OwOday/glasgow_onesided/docs/manual/src/applets/memory/index.rst

.. _applet.memory:

Memory manipulation
===================

.. automodule:: glasgow.applet.memory

.. toctree::
    :maxdepth: 3

    24x
    25x
