OwOday/glasgow_onesided/docs/manual/src/applets/interface/spi_controller.rst

``spi-controller``
==================

CLI reference
-------------

.. _applet.interface.spi_controller:

.. autoprogram:: glasgow.applet.interface.spi_controller:SPIControllerApplet._get_argparser_for_sphinx("spi-controller")
    :prog: glasgow run spi-controller

API reference
-------------

.. module:: glasgow.applet.interface.spi_controller

.. autoclass:: SPIControllerInterface
