OwOday/glasgow_onesided/hardware/boards/glasgow/glasgow.kicad_pcb

## KiCad design hardware/boards/glasgow/glasgow.kicad_pcb (2026-03-15)

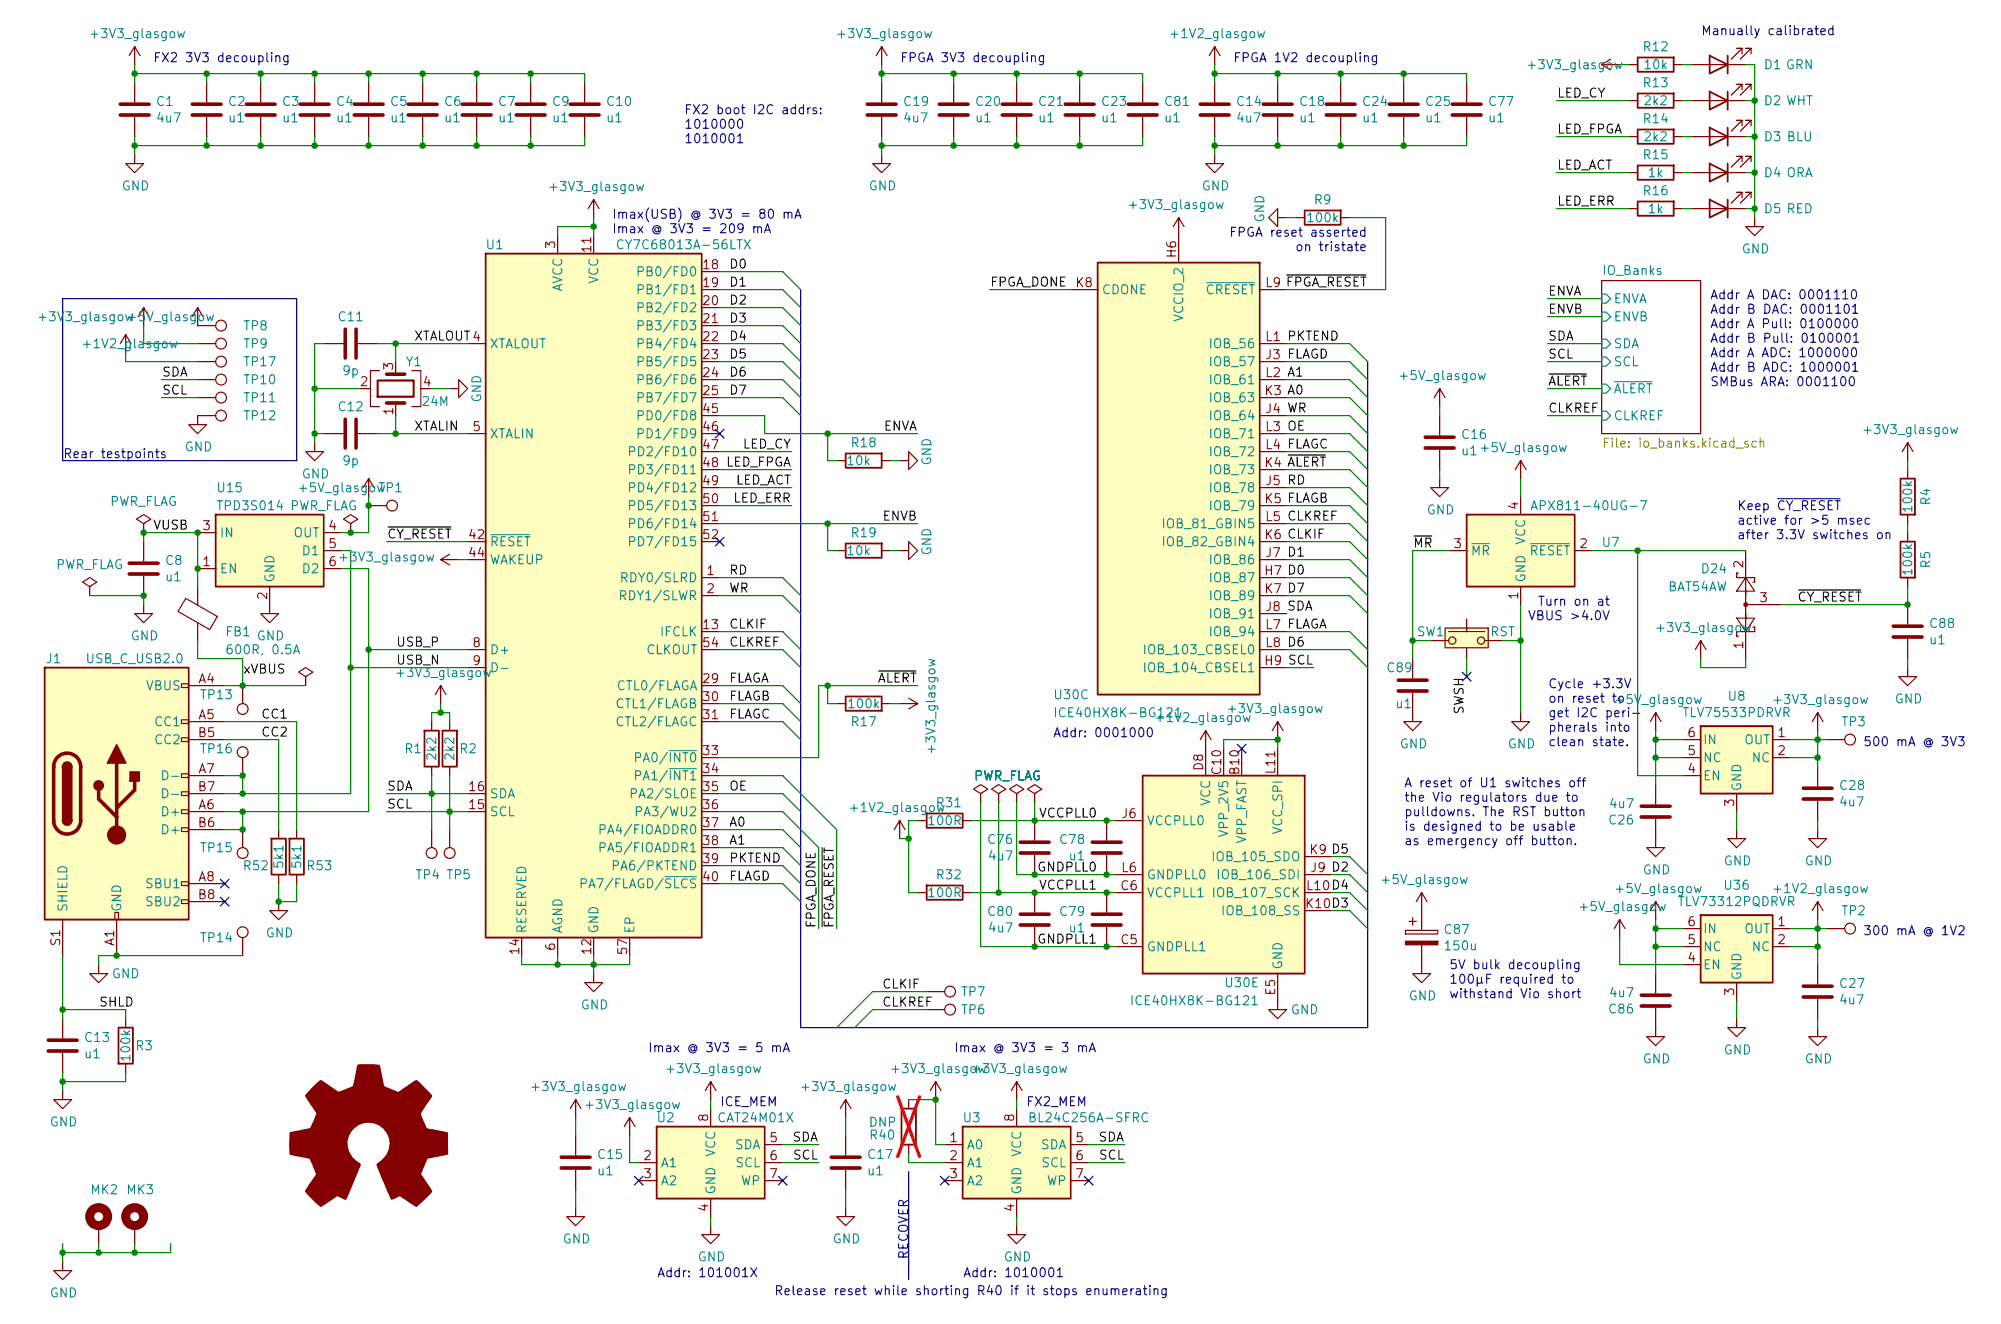
[picture p1: schematic glasgow.kicad_sch, Base Board]

Parts:
C1, C14, C19, C26, C27, C28, C76, C80, C86: 4u7; C_0603_1608Metric; MPN LMK107BJ475KAHT
C2, C3, C4, C5, C6, C7, C8, C9, C10, C13, C15, C16, C17, C18, C20, C21, C23, C24, C25, C77, C78, C79, C81, C88, C89: u1; C_0402_1005Metric; MPN TMK105BJ104KV-F
C11, C12: 9p; C_0402_1005Metric; MPN AC0402CRNPO9BN9R0
C87: 150u; CP_Elec_6.3x5.9; MPN A765EB157M1ALAE022
D1: GRN; LED_0603_1608Metric; MPN NCD0603G1
D2: WHT; LED_0603_1608Metric; MPN NCD0603W1
D3: BLU; LED_0603_1608Metric; MPN ORH-B36G
D4: ORA; LED_0603_1608Metric; MPN NCD0603O1
D5: RED; LED_0603_1608Metric; MPN NCD0603R1
D24: BAT54AW; SOT-323_SC-70; MPN BAT54AW-7-F
FB1: 600R, 0.5A; L_0402_1005Metric; MPN BLM15PX601SZ1D
J1: USB_C_USB2.0; USB_C_Receptacle_HRO_TYPE-C-31-M-12; MPN TYPE-C-31-M-12
MK2, MK3: Mounting_Hole_PAD; MountingHole_3.5mm_Pad_Via_CrtYd
R1, R2, R13, R14: 2k2; R_0402_1005Metric; MPN RC0402FR-132K2L
R3, R4, R5, R9, R17: 100k; R_0402_1005Metric; MPN RC0402FR-13100KL
R12, R18, R19: 10k; R_0402_1005Metric; MPN RC0402FR-1310KL
R15, R16: 1k; R_0402_1005Metric
R31, R32: 100R; R_0402_1005Metric; MPN RC0402FR-13100RL
R40: DNP; R_0402_1005Metric_DNP; not fitted
R52, R53: 5k1; R_0402_1005Metric; MPN RC0402FR-075K1L
SW1: RST; SW_Tactile_SPST_Angled_TC-1109DE; MPN TC-1109DE-B-F
TP1, TP8: 5V; TestPoint_Pad_D1.0mm
TP2, TP17: 1V2; TestPoint_Pad_D1.0mm
TP3, TP7, TP9: 3V3; TestPoint_Pad_D1.0mm
TP4, TP10: SDA; TestPoint_Pad_D1.0mm
TP5, TP11: SCL; TestPoint_Pad_D1.0mm
TP6: CLKREF; TestPoint_Pad_D1.0mm
TP12: GND; TestPoint_Pad_D1.0mm
TP13: VBUS; TestPoint_Pad_D1.0mm
TP14: USBGND; TestPoint_Pad_D1.0mm
TP15: USBDP; TestPoint_Pad_D1.0mm
TP16: USBDM; TestPoint_Pad_D1.0mm
U1: CY7C68013A-56LTX; Cypress_QFN-56-1EP_8x8mm_P0.5mm_EP6.22x6.22mm_ThermalVias; MPN CY7C68013A-56LTXC
U2: CAT24M01X; TSSOP-8_4.4x3mm_P0.65mm; MPN CAT24M01YI−GT3
U3: BL24C256A-SFRC; TSSOP-8_4.4x3mm_P0.65mm; MPN BL24C256A-SFRC
U7: APX811-40UG-7; SOT-143; MPN APX811-40UG-7
U8: TLV75533PDRVR; DFN-6-1EP_2x2mm_P0.65mm_EP1x1.6mm_ThermalVias; MPN TLV75533PDRVR
U15: TPD3S014; SOT-23-6; MPN TPD3S014DBVR
U30: ICE40HX8K-BG121; BGA-121_9.0x9.0mm_Layout11x11_P0.8mm_Ball0.4mm_Pad0.35mm_NS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; MPN ICE40HX8K-BG121
U36: TLV73312PQDRVR; DFN-6-1EP_2x2mm_P0.65mm_EP1x1.6mm_ThermalVias; MPN TLV73312PQDRVRQ1
Y1: 24M; Crystal_SMD_3225-4Pin_3.2x2.5mm; MPN JF4024M00009T8188070

Connections:
+1V2_glasgow: C14.1, C18.1, C24.1, C25.1, C27.1, C77.1, R31.2, R32.2, TP2.1, TP17.1, U30.D4 (VCC), U30.D8 (VCC), U30.H4 (VCC), U30.H8 (VCC), U36.1 (OUT), U36.2 (NC)
+3V3_glasgow: C1.1, C2.1, C3.1, C4.1, C5.1, C6.1, C7.1, C9.1, C10.1, C15.1, C17.1, C19.1, C20.1, C21.1, C23.1, C28.1, C81.1, D24.1, R1.2, R2.2, R4.1, R12.1, R17.2, R40.2, TP3.1, TP9.1, U1.3 (AVCC), U1.7 (AVCC), U1.11 (VCC), U1.17 (VCC), U1.27 (VCC), U1.32 (VCC), U1.43 (VCC), U1.44 (WAKEUP), U1.55 (VCC), U2.2 (A1), U2.8 (VCC), U3.1 (A0), U3.8 (VCC), U8.1 (OUT), U8.2 (NC), U30.C10 (VPP_2V5), U30.H6 (VCCIO_2), U30.L11 (VCC_SPI); also elsewhere on the board
+5V_glasgow: C16.1, C26.2, C86.2, C87.1, TP1.1, TP8.1, U7.4 (VCC), U8.5 (NC), U8.6 (IN), U15.4 (OUT), U36.4 (EN), U36.5 (NC), U36.6 (IN); also elsewhere on the board
/A0: U1.37 (PA4/FIOADDR0), U30.K3 (IOB_63)
/A1: U1.38 (PA5/FIOADDR1), U30.L2 (IOB_61)
/CC1: J1.A5 (CC1), R53.2
/CC2: J1.B5 (CC2), R52.2
/CLKIF: TP7.1, U1.13 (IFCLK), U30.K6 (IOB_82_GBIN4)
/CLKREF: TP6.1, U1.54 (CLKOUT), U30.L5 (IOB_81_GBIN5); also elsewhere on the board
/D0: U1.18 (PB0/FD0), U30.H7 (IOB_87)
/D1: U1.19 (PB1/FD1), U30.J7 (IOB_86)
/D2: U1.20 (PB2/FD2), U30.J9 (IOB_106_SDI)
/D3: U1.21 (PB3/FD3), U30.K10 (IOB_108_SS)
/D4: U1.22 (PB4/FD4), U30.L10 (IOB_107_SCK)
/D5: U1.23 (PB5/FD5), U30.K9 (IOB_105_SDO)
/D6: U1.24 (PB6/FD6), U30.L8 (IOB_103_CBSEL0)
/D7: U1.25 (PB7/FD7), U30.K7 (IOB_89)
/ENVA: R18.1, U1.45 (PD0/FD8); also elsewhere on the board
/ENVB: R19.1, U1.51 (PD6/FD14)
/FLAGA: U1.29 (CTL0/FLAGA), U30.L7 (IOB_94)
/FLAGB: U1.30 (CTL1/FLAGB), U30.K5 (IOB_79)
/FLAGC: U1.31 (CTL2/FLAGC), U30.L4 (IOB_72)
/FLAGD: U1.40 (PA7/FLAGD/~SLCS), U30.J3 (IOB_57)
/FPGA_DONE: U1.36 (PA3/WU2), U30.K8 (CDONE)
/GNDPLL0: C76.2, C78.2, U30.L6 (GNDPLL0)
/GNDPLL1: C79.2, C80.2, U30.C5 (GNDPLL1)
/LED_ACT: R15.1, U1.49 (PD4/FD12)
/LED_CY: R13.1, U1.47 (PD2/FD10)
/LED_ERR: R16.1, U1.50 (PD5/FD13)
/LED_FPGA: R14.1, U1.48 (PD3/FD11)
/OE: U1.35 (PA2/SLOE), U30.L3 (IOB_71)
/PKTEND: U1.39 (PA6/PKTEND), U30.L1 (IOB_56)
/RD: U1.1 (RDY0/SLRD), U30.J5 (IOB_78)
/SCL: R2.1, TP5.1, TP11.1, U1.15 (SCL), U2.6 (SCL), U3.6 (SCL), U30.H9 (IOB_104_CBSEL1); also elsewhere on the board
/SDA: R1.1, TP4.1, TP10.1, U1.16 (SDA), U2.5 (SDA), U3.5 (SDA), U30.J8 (IOB_91); also elsewhere on the board
/SHLD: C13.1, J1.S1 (SHIELD), R3.1
/SWSH: SW1.3
/USB_N: J1.A7 (D-), J1.B7 (D-), TP16.1, U1.9 (D-), U15.5 (D1)
/USB_P: J1.A6 (D+), J1.B6 (D+), TP15.1, U1.8 (D+), U15.6 (D2)
/VCCPLL0: C76.1, C78.1, R31.1, U30.J6 (VCCPLL0)
/VCCPLL1: C79.1, C80.1, R32.1, U30.C6 (VCCPLL1)
/VUSB: C8.1, FB1.2, U15.1 (EN), U15.3 (IN)
/WR: U1.2 (RDY1/SLWR), U30.J4 (IOB_64)
/XTALIN: C12.1, U1.5 (XTALIN), Y1.1
/XTALOUT: C11.1, U1.4 (XTALOUT), Y1.3
/xVBUS: FB1.1, J1.A4 (VBUS), J1.A9 (VBUS), J1.B4 (VBUS), J1.B9 (VBUS), TP13.1
/~ALERT: R17.1, U1.33 (PA0/~INT0), U30.K4 (IOB_73); also elsewhere on the board
/~CY_RESET: C88.1, D24.3, R5.2, U1.42 (~RESET)
/~FPGA_RESET: R9.2, U1.34 (PA1/~INT1), U30.L9 (~CRESET)
/~MR: C89.1, SW1.2, U7.3 (~MR)
GND: C1.2, C2.2, C3.2, C4.2, C5.2, C6.2, C7.2, C8.2, C9.2, C10.2, C11.2, C12.2, C13.2, C14.2, C15.2, C16.2, C17.2, C18.2, C19.2, C20.2, C21.2, C23.2, C24.2, C25.2, C26.1, C27.2, C28.2, C77.2, C81.2, C86.1, C87.2, C88.2, C89.2, D1.1 (K), D2.1 (K), D3.1 (K), D4.1 (K), D5.1 (K), J1.A1 (GND), J1.A12 (GND), J1.B1 (GND), J1.B12 (GND), MK2.1, MK3.1, R3.2, R9.1, R18.2, R19.2, R52.1, R53.1, SW1.1, TP12.1, TP14.1, U1.6 (AGND), U1.10 (AGND), U1.12 (GND), U1.14 (RESERVED), U1.26 (GND), U1.28 (GND), U1.41 (GND), U1.53 (GND), U1.56 (GND), U1.57 (EP), U2.4 (GND), U3.4 (GND), U7.1 (GND), U8.3 (GND), U8.7 (GND), U15.2 (GND), U30.E5 (GND), U30.E6 (GND), U30.E7 (GND), U30.F5 (GND), U30.F6 (GND), U30.F7 (GND), U30.G5 (GND), U30.G6 (GND), U30.G7 (GND), U30.H5 (GND), U36.3 (GND), U36.7 (GND), Y1.2, Y1.4; also elsewhere on the board
unnamed: D1.2 (A), R12.2
unnamed: D2.2 (A), R13.2
unnamed: D3.2 (A), R14.2
unnamed: D4.2 (A), R15.2
unnamed: D5.2 (A), R16.2
unnamed: R4.2, R5.1
unnamed: R40.1, U3.2 (A1)
unnamed: D24.2, U7.2 (~RESET), U8.4 (EN)

Notes on the sheet:
Turn on at VBUS >4.0V
Addr: 1010001
RECOVER
Imax @ 3V3 = 3 mA
Cycle +3.3V on reset to get I2C peri- pherals into clean state.
500 mA @ 3V3
FX2_MEM
Release reset while shorting R40 if it stops enumerating
Addr: 0001000
Manually calibrated
FPGA 3V3 decoupling
FPGA reset asserted on tristate
FX2 3V3 decoupling
Imax @ 3V3 = 5 mA
FX2 boot I2C addrs: 1010000 1010001
A reset of U1 switches off the Vio regulators due to pulldowns. The RST button is designed to be usable as emergency off button.
Addr A DAC: 0001110 Addr B DAC: 0001101 Addr A Pull: 0100000 Addr B Pull: 0100001 Addr A ADC: 1000000 Addr B ADC: 1000001 SMBus ARA: 0001100
Rear testpoints
5V bulk decoupling 100µF required to withstand Vio short
Imax(USB) @ 3V3 = 80 mA Imax @ 3V3 = 209 mA
FPGA 1V2 decoupling
Addr: 101001X
Keep ~{CY_RESET} active for >5 msec after 3.3V switches on
300 mA @ 1V2
ICE_MEM

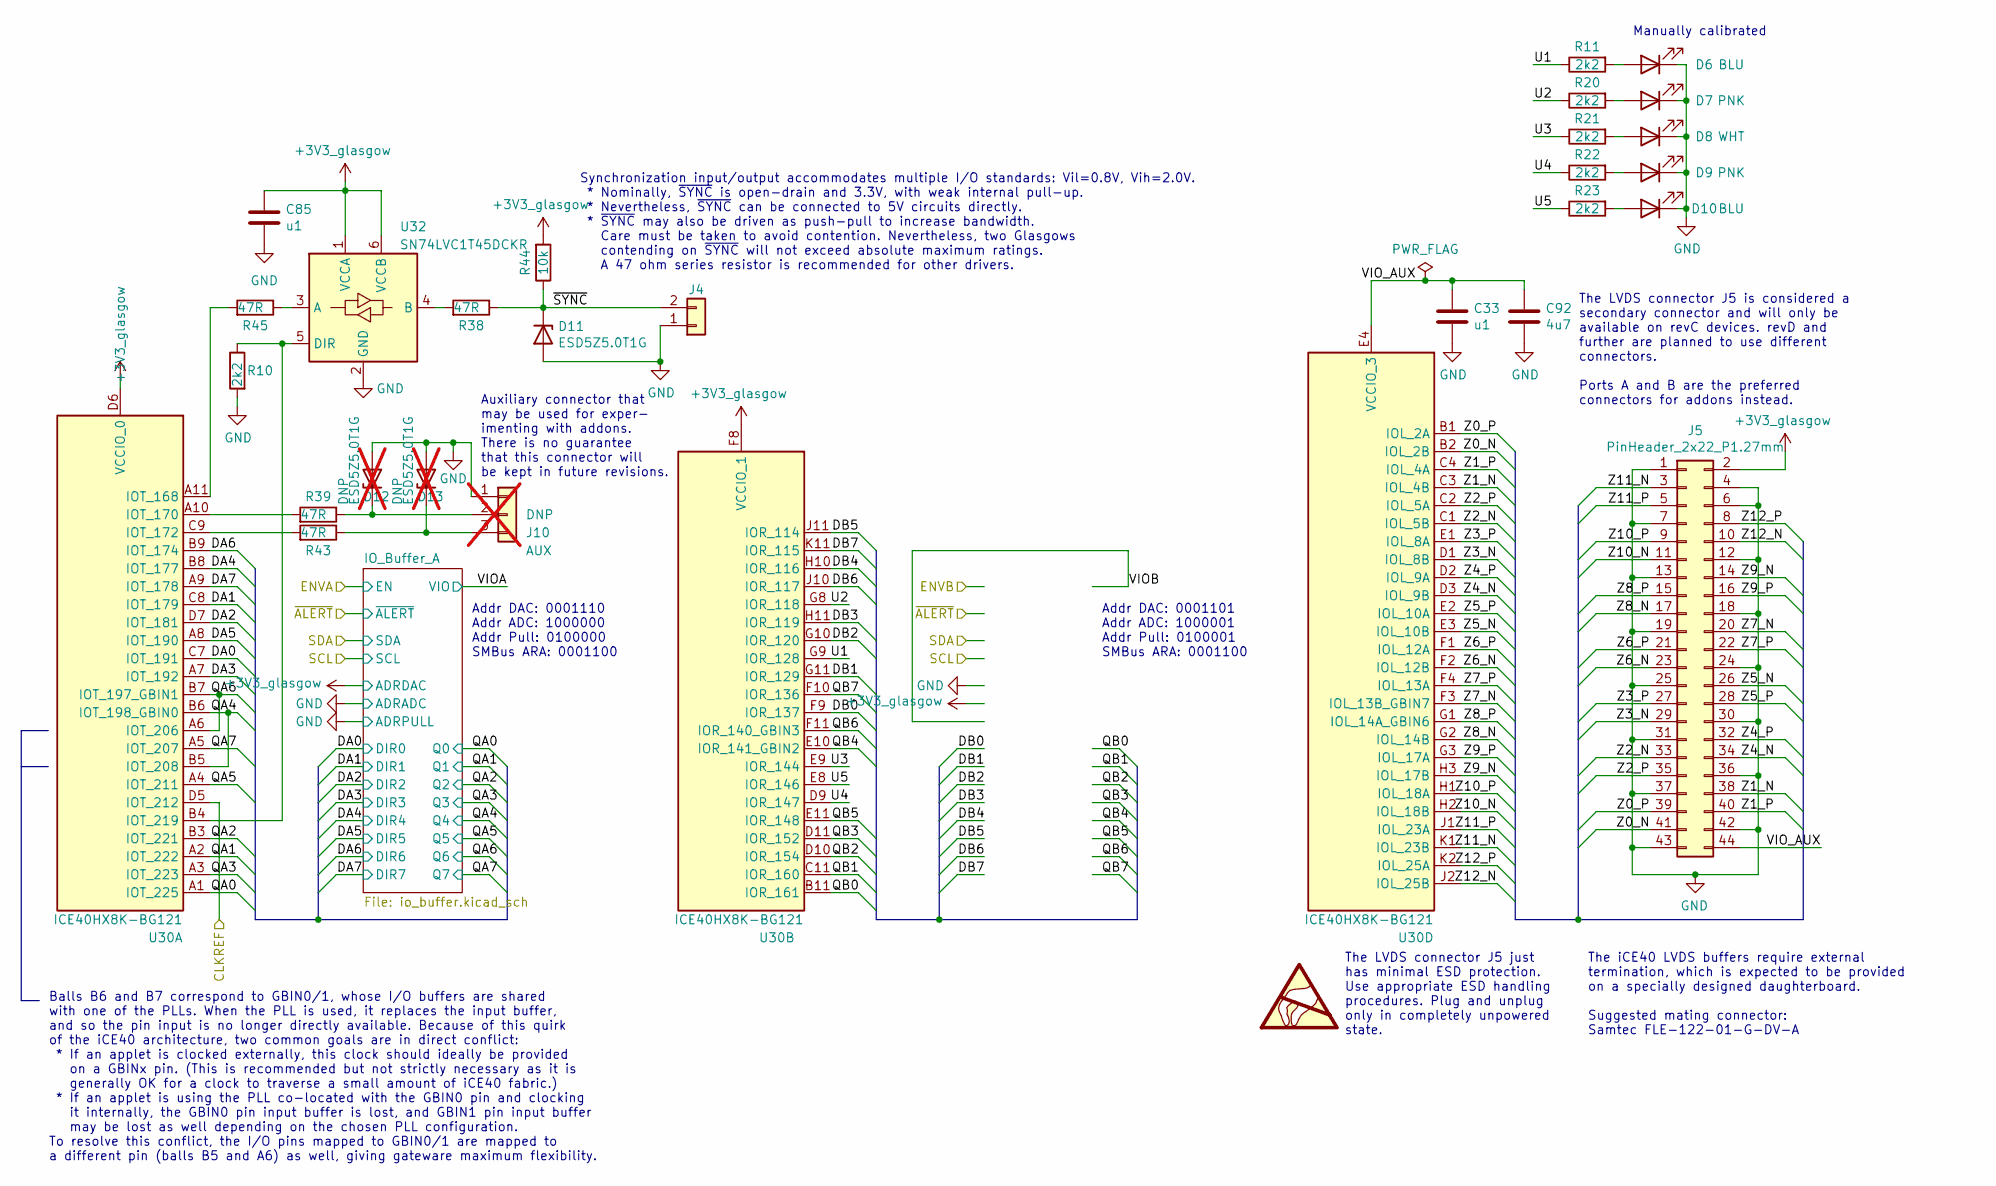
[picture p2: schematic io_banks.kicad_sch, I/O Banks]

Parts:
C33, C85: u1; C_0402_1005Metric; MPN TMK105BJ104KV-F
C92: 4u7; C_0603_1608Metric; MPN LMK107BJ475KAHT
D6, D10: BLU; LED_0603_1608Metric; MPN ORH-B36G
D7, D9: PNK; LED_0603_1608Metric; MPN OSK40603C1E
D8: WHT; LED_0603_1608Metric; MPN NCD0603W1
D11: ESD5Z5.0T1G; D_SOD-523; MPN ESD5Z5.0T1G
D12, D13: ESD5Z5.0T1G; D_SOD-523; MPN ESD5Z5.0T1G; not fitted
J4: Conn_01x02; Molex_KK-254_1x02_P2.54mm_Horizontal; MPN 22-05-3021
J5: PinHeader_2x22_P1.27mm; PinHeader_2x22_P1.27mm_Vertical__SMD; MPN FTS-122-01-L-DV
J10: AUX; PinHeader_1x03_P2.54mm_Vertical; not fitted
R10, R11, R20, R21, R22, R23: 2k2; R_0402_1005Metric; MPN RC0402FR-132K2L
R38, R39, R43, R45: 47R; R_0402_1005Metric; MPN RC0402FR-1347RL
R44: 10k; R_0402_1005Metric; MPN RC0402FR-1310KL
U30: ICE40HX8K-BG121; BGA-121_9.0x9.0mm_Layout11x11_P0.8mm_Ball0.4mm_Pad0.35mm_NS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; MPN ICE40HX8K-BG121
U32: SN74LVC1T45DCKR; SOT-363_SC-70-6; MPN SN74LVC1T45DCKR

Connections:
+3V3_glasgow: C85.1, J5.2, R44.2, U30.D6 (VCCIO_0), U30.F8 (VCCIO_1), U32.1 (VCCA), U32.6 (VCCB); also elsewhere on the board
/CLKREF: U30.D5 (IOT_212); also elsewhere on the board
/IO_Banks/DA0: U30.C7 (IOT_191); also elsewhere on the board
/IO_Banks/DA1: U30.C8 (IOT_179); also elsewhere on the board
/IO_Banks/DA2: U30.D7 (IOT_181); also elsewhere on the board
/IO_Banks/DA3: U30.A7 (IOT_192); also elsewhere on the board
/IO_Banks/DA4: U30.B8 (IOT_177); also elsewhere on the board
/IO_Banks/DA5: U30.A8 (IOT_190); also elsewhere on the board
/IO_Banks/DA6: U30.B9 (IOT_174); also elsewhere on the board
/IO_Banks/DA7: U30.A9 (IOT_178); also elsewhere on the board
/IO_Banks/DB0: U30.F9 (IOR_137)
/IO_Banks/DB1: U30.G11 (IOR_129)
/IO_Banks/DB2: U30.G10 (IOR_120)
/IO_Banks/DB3: U30.H11 (IOR_119)
/IO_Banks/DB4: U30.H10 (IOR_116)
/IO_Banks/DB5: U30.J11 (IOR_114)
/IO_Banks/DB6: U30.J10 (IOR_117)
/IO_Banks/DB7: U30.K11 (IOR_115)
/IO_Banks/QA0: U30.A1 (IOT_225); also elsewhere on the board
/IO_Banks/QA1: U30.A2 (IOT_222); also elsewhere on the board
/IO_Banks/QA2: U30.B3 (IOT_221); also elsewhere on the board
/IO_Banks/QA3: U30.A3 (IOT_223); also elsewhere on the board
/IO_Banks/QA4: U30.B5 (IOT_208), U30.B6 (IOT_198_GBIN0); also elsewhere on the board
/IO_Banks/QA5: U30.A4 (IOT_211); also elsewhere on the board
/IO_Banks/QA6: U30.A6 (IOT_206), U30.B7 (IOT_197_GBIN1); also elsewhere on the board
/IO_Banks/QA7: U30.A5 (IOT_207); also elsewhere on the board
/IO_Banks/QB0: U30.B11 (IOR_161)
/IO_Banks/QB1: U30.C11 (IOR_160)
/IO_Banks/QB2: U30.D10 (IOR_154)
/IO_Banks/QB3: U30.D11 (IOR_152)
/IO_Banks/QB4: U30.E10 (IOR_141_GBIN2)
/IO_Banks/QB5: U30.E11 (IOR_148)
/IO_Banks/QB6: U30.F11 (IOR_140_GBIN3)
/IO_Banks/QB7: U30.F10 (IOR_136)
/IO_Banks/U1: R11.1, U30.G9 (IOR_128)
/IO_Banks/U2: R20.1, U30.G8 (IOR_118)
/IO_Banks/U3: R21.1, U30.E9 (IOR_144)
/IO_Banks/U4: R22.1, U30.D9 (IOR_147)
/IO_Banks/U5: R23.1, U30.E8 (IOR_146)
/IO_Banks/VIO_AUX: C33.1, C92.1, J5.44, U30.E4 (VCCIO_3), U30.G4 (VCCIO_3)
/IO_Banks/Z0_N: J5.41, U30.B2 (IOL_2B)
/IO_Banks/Z0_P: J5.39, U30.B1 (IOL_2A)
/IO_Banks/Z1_N: J5.38, U30.C3 (IOL_4B)
/IO_Banks/Z1_P: J5.40, U30.C4 (IOL_4A)
/IO_Banks/Z2_N: J5.33, U30.C1 (IOL_5B)
/IO_Banks/Z2_P: J5.35, U30.C2 (IOL_5A)
/IO_Banks/Z3_N: J5.29, U30.D1 (IOL_8B)
/IO_Banks/Z3_P: J5.27, U30.E1 (IOL_8A)
/IO_Banks/Z4_N: J5.34, U30.D3 (IOL_9B)
/IO_Banks/Z4_P: J5.32, U30.D2 (IOL_9A)
/IO_Banks/Z5_N: J5.26, U30.E3 (IOL_10B)
/IO_Banks/Z5_P: J5.28, U30.E2 (IOL_10A)
/IO_Banks/Z6_N: J5.23, U30.F2 (IOL_12B)
/IO_Banks/Z6_P: J5.21, U30.F1 (IOL_12A)
/IO_Banks/Z7_N: J5.20, U30.F3 (IOL_13B_GBIN7)
/IO_Banks/Z7_P: J5.22, U30.F4 (IOL_13A)
/IO_Banks/Z8_N: J5.17, U30.G2 (IOL_14B)
/IO_Banks/Z8_P: J5.15, U30.G1 (IOL_14A_GBIN6)
/IO_Banks/Z9_N: J5.14, U30.H3 (IOL_17B)
/IO_Banks/Z9_P: J5.16, U30.G3 (IOL_17A)
/IO_Banks/Z10_N: J5.11, U30.H2 (IOL_18B)
/IO_Banks/Z10_P: J5.9, U30.H1 (IOL_18A)
/IO_Banks/Z11_N: J5.3, U30.K1 (IOL_23B)
/IO_Banks/Z11_P: J5.5, U30.J1 (IOL_23A)
/IO_Banks/Z12_N: J5.10, U30.J2 (IOL_25B)
/IO_Banks/Z12_P: J5.8, U30.K2 (IOL_25A)
/IO_Banks/~SYNC: D11.1 (K), J4.2, R38.1, R44.1
GND: C33.2, C85.2, C92.2, D6.1 (K), D7.1 (K), D8.1 (K), D9.1 (K), D10.1 (K), D11.2 (A), D12.2 (A), D13.2 (A), J4.1, J5.1, J5.4, J5.6, J5.7, J5.12, J5.13, J5.18, J5.19, J5.24, J5.25, J5.30, J5.31, J5.36, J5.37, J5.42, J5.43, J10.1, R10.2, U32.2 (GND); also elsewhere on the board
unnamed: D6.2 (A), R11.2
unnamed: D7.2 (A), R20.2
unnamed: D8.2 (A), R21.2
unnamed: D9.2 (A), R22.2
unnamed: D10.2 (A), R23.2
unnamed: D12.1 (K), J10.2, R39.1
unnamed: D13.1 (K), J10.3, R43.1
unnamed: R45.2, U30.A11 (IOT_168)
unnamed: R39.2, U30.A10 (IOT_170)
unnamed: R43.2, U30.C9 (IOT_172)
unnamed: R10.1, U30.B4 (IOT_219), U32.5 (DIR)
unnamed: R45.1, U32.3 (A)
unnamed: R38.2, U32.4 (B)

Notes on the sheet:
The LVDS connector J5 is considered a secondary connector and will only be available on revC devices. revD and further are planned to use different connectors. Ports A and B are the preferred connectors for addons instead.
Addr DAC: 0001101 Addr ADC: 1000001 Addr Pull: 0100001 SMBus ARA: 0001100
The iCE40 LVDS buffers require external termination, which is expected to be provided on a specially designed daughterboard. Suggested mating connector: Samtec FLE-122-01-G-DV-A
Auxiliary connector that may be used for exper- imenting with addons. There is no guarantee that this connector will be kept in future revisions.
Manually calibrated
Addr DAC: 0001110 Addr ADC: 1000000 Addr Pull: 0100000 SMBus ARA: 0001100
Balls B6 and B7 correspond to GBIN0/1, whose I/O buffers are shared with one of the PLLs. When the PLL is used, it replaces the input buffer, and so the pin input is no longer directly available. Because of this quirk of the iCE40 architecture, two common goals are in direct conflict: * If an apple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
Synchronization input/output accommodates multiple I/O standards: Vil=0.8V, Vih=2.0V. * Nominally, ~{SYNC} is open-drain and 3.3V, with weak internal pull-up. * Nevertheless, ~{SYNC} can be connected to 5V circuits directly. * ~{SYNC} may also be driven as push-pull to increase bandwidth. Care must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
The LVDS connector J5 just has minimal ESD protection. Use appropriate ESD handling procedures. Plug and unplug only in completely unpowered state.

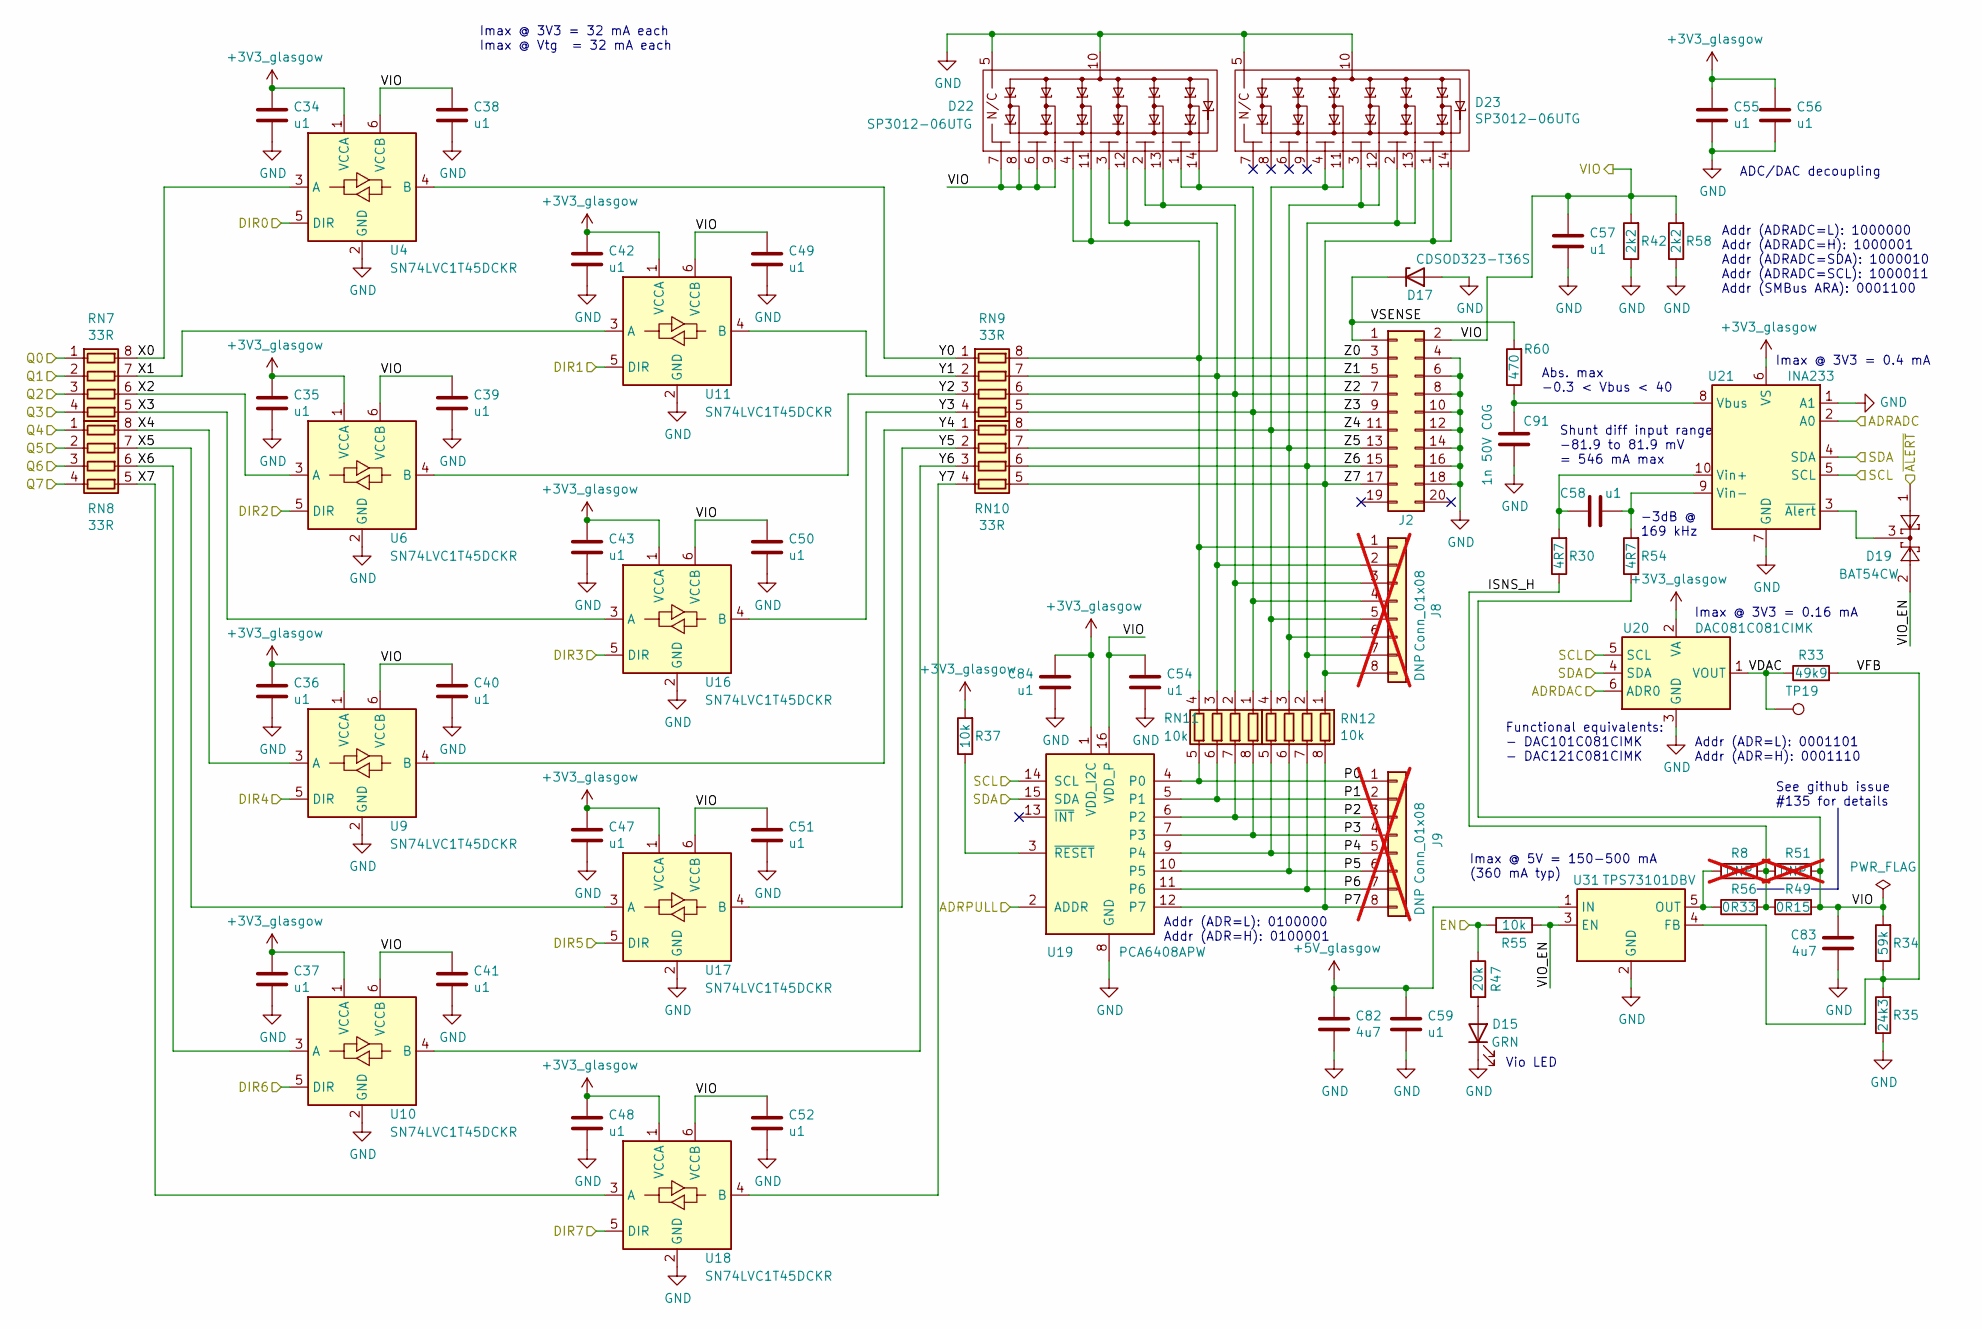
[picture p3: schematic io_buffer.kicad_sch, I/O Buffer]

Parts:
C34, C35, C36, C37, C38, C39, C40, C41, C42, C43, C47, C48, C49, C50, C51, C52, C54, C55, C56, C57, C58, C59, C84: u1; C_0402_1005Metric; MPN TMK105BJ104KV-F
C82, C83: 4u7; C_0603_1608Metric; MPN LMK107BJ475KAHT
C91: 1n 50V C0G; C_0402_1005Metric; MPN GCM1555C1H102JA16J
D15: GRN; LED_0603_1608Metric; MPN NCD0603G1
D17: CDSOD323-T36S; D_SOD-323; MPN CDSOD323-T36S
D19: BAT54CW; SOT-323_SC-70; MPN BAT54CW-7-F
D22, D23: SP3012-06UTG; UDFN-14_3.5x1.35mm_P0.5mm; MPN SP3012-06UTG
J2: IDC-Header_2x10_P2.54mm; IDC-Header_2x10_P2.54mm_Vertical; MPN 87834-2019
J8, J9: Conn_01x08; PinSocket_1x08_P1.27mm_Vertical_DNP; not fitted
R8, R51: DNP; R_0603_1608Metric_DNP; not fitted
R30, R54: 4R7; R_0402_1005Metric; MPN RC0402FR-074R7L
R33: 49k9; R_0402_1005Metric; MPN RC0402FR-1349K9L
R34: 59k; R_0402_1005Metric; MPN RC0402FR-1359KL
R35: 24k3; R_0402_1005Metric; MPN RC0402FR-1324K3L
R37, R55: 10k; R_0402_1005Metric; MPN RC0402FR-1310KL
R42, R58: 2k2; R_0402_1005Metric; MPN RC0402FR-132K2L
R47: 20k; R_0402_1005Metric; MPN RC0402FR-1320KL
R49: 0R15; R_0603_1608Metric; MPN KDV06FR150ET
R56: 0R33; R_0603_1608Metric; MPN KDV06FR330ET
R60: 470; R_0402_1005Metric; MPN RC0402FR-07470RL
RN7, RN8, RN9, RN10: 33R; R_Array_Convex_4x0402; MPN YC124-JR-1333RL
RN11, RN12: 10k; R_Array_Convex_4x0402; MPN YC124-JR-0710KL
TP19: VDAC; TestPoint_Pad_D1.0mm
U4, U6, U9, U10, U11, U16, U17, U18: SN74LVC1T45DCKR; SOT-363_SC-70-6; MPN SN74LVC1T45DCKR
U19: PCA6408APW; TSSOP-16_4.4x5mm_P0.65mm; MPN PCA6408APW
U20: DAC081C081CIMK; SOT-23-6; MPN DAC081C081CIMK/NOPB
U21: INA233; VSSOP-10_3x3mm_P0.5mm; MPN INA233AIDGSR
U31: TPS73101DBV; SOT-23-5; MPN TPS73101DBVR

Connections:
+3V3_glasgow: C34.1, C35.1, C36.1, C37.1, C42.1, C43.1, C47.1, C48.1, C55.1, C56.1, C84.1, R37.2, U4.1 (VCCA), U6.1 (VCCA), U9.1 (VCCA), U10.1 (VCCA), U11.1 (VCCA), U16.1 (VCCA), U17.1 (VCCA), U18.1 (VCCA), U19.1 (VDD_I2C), U20.2 (VA), U20.6 (ADR0), U21.6 (VS); also elsewhere on the board
+5V_glasgow: C59.1, C82.1, U31.1 (IN); also elsewhere on the board
/ENVA: R47.1, R55.2; also elsewhere on the board
/IO_Banks/DA0: U4.5 (DIR); also elsewhere on the board
/IO_Banks/DA1: U11.5 (DIR); also elsewhere on the board
/IO_Banks/DA2: U6.5 (DIR); also elsewhere on the board
/IO_Banks/DA3: U16.5 (DIR); also elsewhere on the board
/IO_Banks/DA4: U9.5 (DIR); also elsewhere on the board
/IO_Banks/DA5: U17.5 (DIR); also elsewhere on the board
/IO_Banks/DA6: U10.5 (DIR); also elsewhere on the board
/IO_Banks/DA7: U18.5 (DIR); also elsewhere on the board
/IO_Banks/IO_Buffer_A/ISNS_H: R8.2, R30.1, R49.1, R51.1, R56.2
/IO_Banks/IO_Buffer_A/P0: J9.1, RN11.5 (R4.2), U19.4 (P0)
/IO_Banks/IO_Buffer_A/P1: J9.2, RN11.6 (R3.2), U19.5 (P1)
/IO_Banks/IO_Buffer_A/P2: J9.3, RN11.7 (R2.2), U19.6 (P2)
/IO_Banks/IO_Buffer_A/P3: J9.4, RN11.8 (R1.2), U19.7 (P3)
/IO_Banks/IO_Buffer_A/P4: J9.5, RN12.5 (R4.2), U19.9 (P4)
/IO_Banks/IO_Buffer_A/P5: J9.6, RN12.6 (R3.2), U19.10 (P5)
/IO_Banks/IO_Buffer_A/P6: J9.7, RN12.7 (R2.2), U19.11 (P6)
/IO_Banks/IO_Buffer_A/P7: J9.8, RN12.8 (R1.2), U19.12 (P7)
/IO_Banks/IO_Buffer_A/VDAC: R33.1, TP19.1, U20.1 (VOUT)
/IO_Banks/IO_Buffer_A/VFB: R33.2, R34.1, R35.2, U31.4 (FB)
/IO_Banks/IO_Buffer_A/VIO_EN: D19.2, R55.1, U31.3 (EN)
/IO_Banks/IO_Buffer_A/VSENSE: D17.1 (K), J2.1, R60.2
/IO_Banks/IO_Buffer_A/X0: RN7.8 (R1.2), U4.3 (A)
/IO_Banks/IO_Buffer_A/X1: RN7.7 (R2.2), U11.3 (A)
/IO_Banks/IO_Buffer_A/X2: RN7.6 (R3.2), U6.3 (A)
/IO_Banks/IO_Buffer_A/X3: RN7.5 (R4.2), U16.3 (A)
/IO_Banks/IO_Buffer_A/X4: RN8.8 (R1.2), U9.3 (A)
/IO_Banks/IO_Buffer_A/X5: RN8.7 (R2.2), U17.3 (A)
/IO_Banks/IO_Buffer_A/X6: RN8.6 (R3.2), U10.3 (A)
/IO_Banks/IO_Buffer_A/X7: RN8.5 (R4.2), U18.3 (A)
/IO_Banks/IO_Buffer_A/Y0: RN9.1 (R1.1), U4.4 (B)
/IO_Banks/IO_Buffer_A/Y1: RN9.2 (R2.1), U11.4 (B)
/IO_Banks/IO_Buffer_A/Y2: RN9.3 (R3.1), U6.4 (B)
/IO_Banks/IO_Buffer_A/Y3: RN9.4 (R4.1), U16.4 (B)
/IO_Banks/IO_Buffer_A/Y4: RN10.1 (R1.1), U9.4 (B)
/IO_Banks/IO_Buffer_A/Y5: RN10.2 (R2.1), U17.4 (B)
/IO_Banks/IO_Buffer_A/Y6: RN10.3 (R3.1), U10.4 (B)
/IO_Banks/IO_Buffer_A/Y7: RN10.4 (R4.1), U18.4 (B)
/IO_Banks/IO_Buffer_A/Z0: D22.4 (N/C), D22.11 (Ch4), J2.3, J8.1, RN9.8 (R1.2), RN11.4 (R4.1)
/IO_Banks/IO_Buffer_A/Z1: D22.3 (N/C), D22.12 (Ch3), J2.5, J8.2, RN9.7 (R2.2), RN11.3 (R3.1)
/IO_Banks/IO_Buffer_A/Z2: D22.2 (N/C), D22.13 (Ch2), J2.7, J8.3, RN9.6 (R3.2), RN11.2 (R2.1)
/IO_Banks/IO_Buffer_A/Z3: D22.1 (N/C), D22.14 (Ch1), J2.9, J8.4, RN9.5 (R4.2), RN11.1 (R1.1)
/IO_Banks/IO_Buffer_A/Z4: D23.4 (N/C), D23.11 (Ch4), J2.11, J8.5, RN10.8 (R1.2), RN12.4 (R4.1)
/IO_Banks/IO_Buffer_A/Z5: D23.3 (N/C), D23.12 (Ch3), J2.13, J8.6, RN10.7 (R2.2), RN12.3 (R3.1)
/IO_Banks/IO_Buffer_A/Z6: D23.2 (N/C), D23.13 (Ch2), J2.15, J8.7, RN10.6 (R3.2), RN12.2 (R2.1)
/IO_Banks/IO_Buffer_A/Z7: D23.1 (N/C), D23.14 (Ch1), J2.17, J8.8, RN10.5 (R4.2), RN12.1 (R1.1)
/IO_Banks/QA0: RN7.1 (R1.1); also elsewhere on the board
/IO_Banks/QA1: RN7.2 (R2.1); also elsewhere on the board
/IO_Banks/QA2: RN7.3 (R3.1); also elsewhere on the board
/IO_Banks/QA3: RN7.4 (R4.1); also elsewhere on the board
/IO_Banks/QA4: RN8.1 (R1.1); also elsewhere on the board
/IO_Banks/QA5: RN8.2 (R2.1); also elsewhere on the board
/IO_Banks/QA6: RN8.3 (R3.1); also elsewhere on the board
/IO_Banks/QA7: RN8.4 (R4.1); also elsewhere on the board
/IO_Banks/VIOA: C38.1, C39.1, C40.1, C41.1, C49.1, C50.1, C51.1, C52.1, C54.1, C57.1, C83.1, D22.6 (N/C), D22.7 (N/C), D22.8 (Ch6), D22.9 (Ch5), J2.2, R34.2, R42.2, R49.2, R51.2, R54.1, R58.2, U4.6 (VCCB), U6.6 (VCCB), U9.6 (VCCB), U10.6 (VCCB), U11.6 (VCCB), U16.6 (VCCB), U17.6 (VCCB), U18.6 (VCCB), U19.16 (VDD_P)
/SCL: U19.14 (SCL), U20.5 (SCL), U21.5 (SCL); also elsewhere on the board
/SDA: U19.15 (SDA), U20.4 (SDA), U21.4 (SDA); also elsewhere on the board
/~ALERT: D19.1; also elsewhere on the board
GND: C34.2, C35.2, C36.2, C37.2, C38.2, C39.2, C40.2, C41.2, C42.2, C43.2, C47.2, C48.2, C49.2, C50.2, C51.2, C52.2, C54.2, C55.2, C56.2, C57.2, C59.2, C82.2, C83.2, C84.2, C91.1, D15.1 (K), D17.2 (A), D22.5 (N/C), D22.10 (GND), D23.5 (N/C), D23.10 (GND), J2.4, J2.6, J2.8, J2.10, J2.12, J2.14, J2.16, J2.18, R35.1, R42.1, R58.1, U4.2 (GND), U6.2 (GND), U9.2 (GND), U10.2 (GND), U11.2 (GND), U16.2 (GND), U17.2 (GND), U18.2 (GND), U19.2 (ADDR), U19.8 (GND), U20.3 (GND), U21.1 (A1), U21.2 (A0), U21.7 (GND), U31.2 (GND); also elsewhere on the board
unnamed: D15.2 (A), R47.2
unnamed: R37.1, U19.3 (~RESET)
unnamed: C91.2, R60.1, U21.8 (Vbus)
unnamed: C58.2, R30.2, U21.10 (Vin+)
unnamed: C58.1, R54.2, U21.9 (Vin-)
unnamed: D19.3, U21.3 (~Alert)
unnamed: R8.1, R56.1, U31.5 (OUT)

Notes on the sheet:
Imax @ 5V = 150-500 mA (360 mA typ)
ADC/DAC decoupling
Vio LED
Imax @ 3V3 = 32 mA each Imax @ Vtg = 32 mA each
Imax @ 3V3 = 0.4 mA
Shunt diff input range -81.9 to 81.9 mV = 546 mA max
See github issue #135 for details
Abs. max -0.3 < Vbus < 40
-3dB @ 169 kHz
Addr (ADR=L): 0001101 Addr (ADR=H): 0001110
Addr (ADR=L): 0100000 Addr (ADR=H): 0100001
Addr (ADRADC=L): 1000000 Addr (ADRADC=H): 1000001 Addr (ADRADC=SDA): 1000010 Addr (ADRADC=SCL): 1000011 Addr (SMBus ARA): 0001100
Functional equivalents: - DAC101C081CIMK - DAC121C081CIMK
Imax @ 3V3 = 0.16 mA

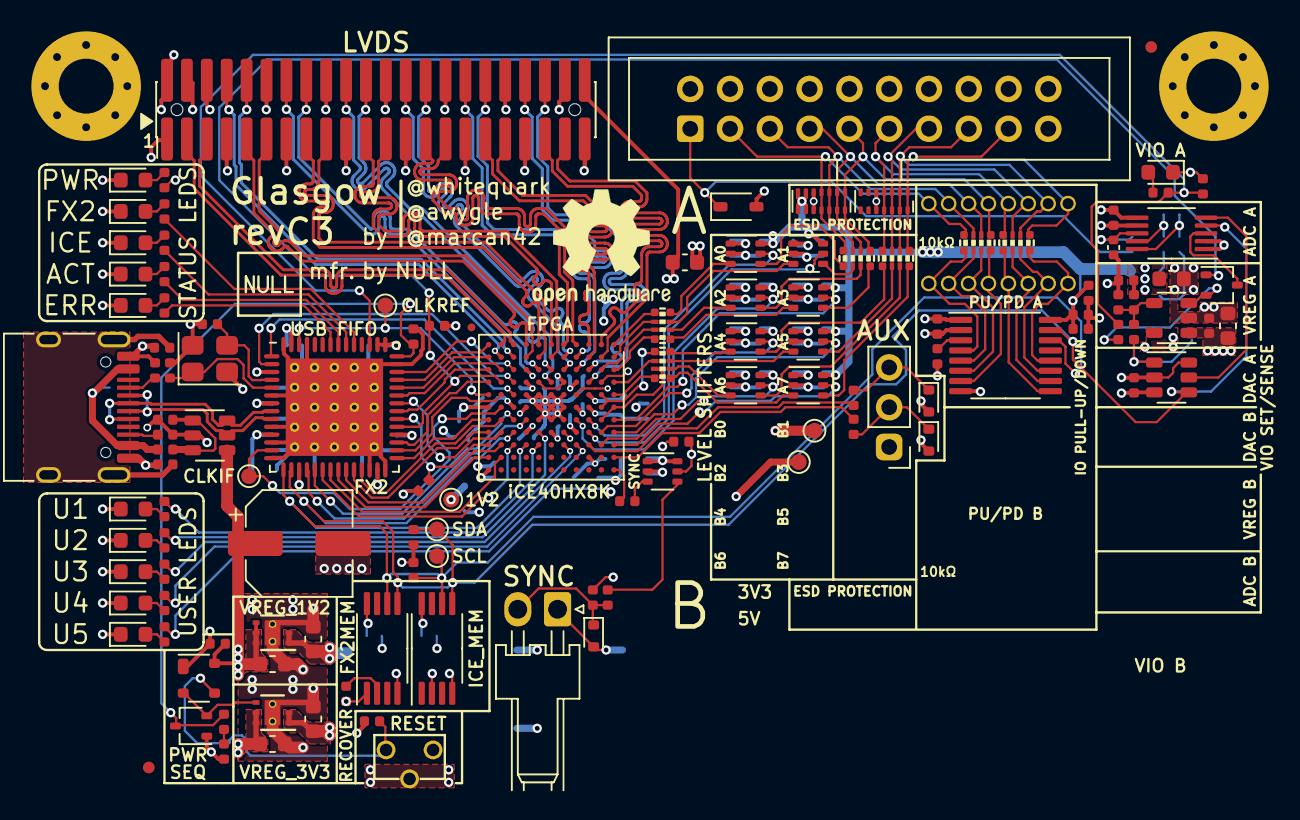
[picture p4: board glasgow.kicad_pcb from above]

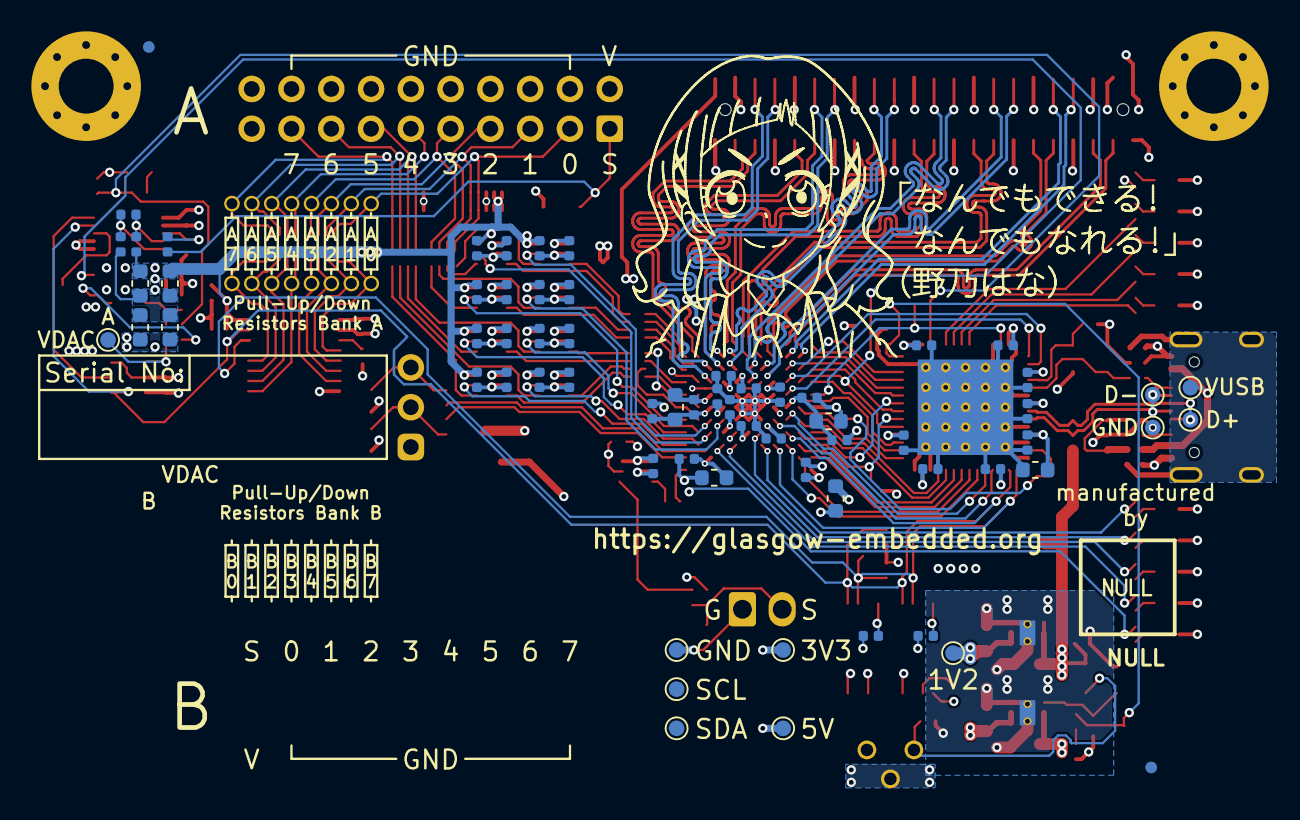
[picture p5: board glasgow.kicad_pcb from below]

Board: 4 copper layers, 192 parts (67 on the bottom side), 164 nets.

Other parts of the board:
FID1, FID2, FID4, FID5: Fiducial_0.75mm_Mask1.5mm
FID8: Fiducial_0.5mm_Dia_1mm_Outer
NONO_HANA: MECHOKKU; nono_hana_lines
